JorandRunningenNTNU/ByggernLab/Hardware versjonskontroll/Lab 2.jpg

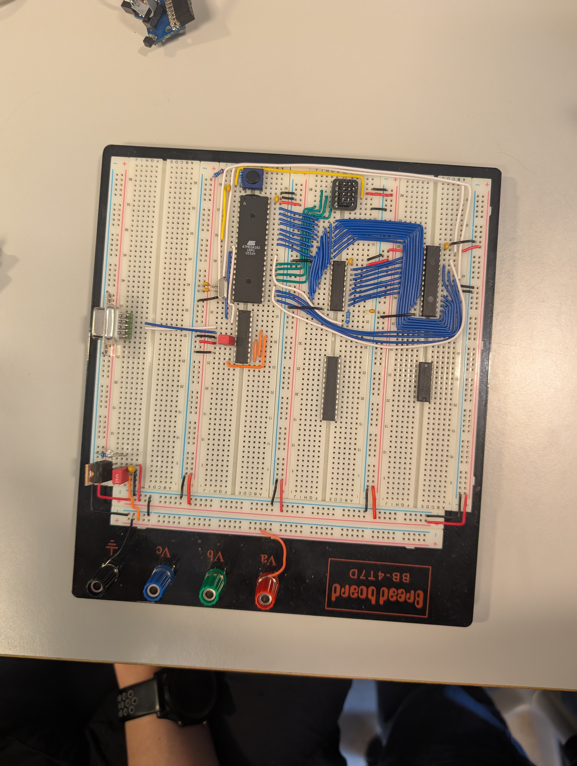
Hardware versjonskontroll/Lab 2.jpg
