JorandRunningenNTNU/ByggernLab/Hardware versjonskontroll/Lab 3.jpg

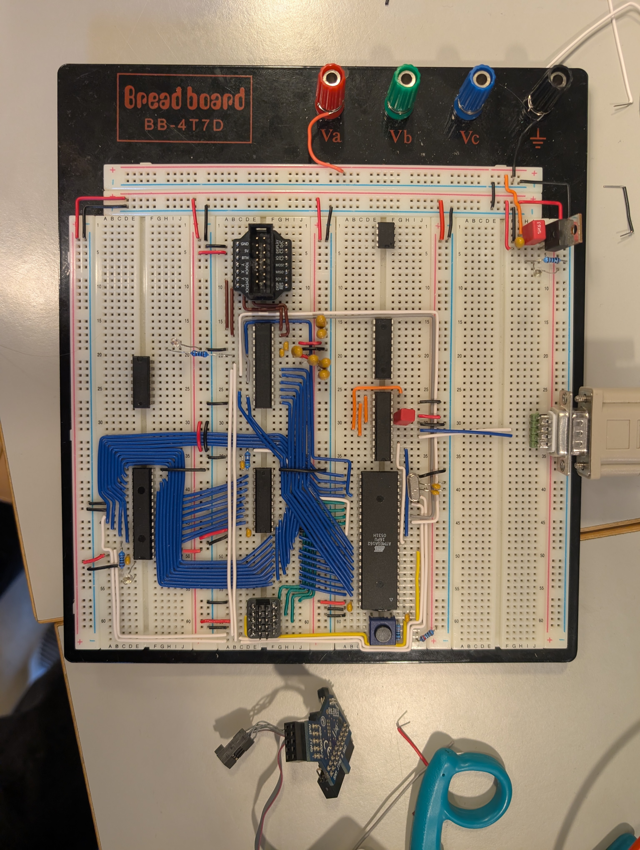
Hardware versjonskontroll/Lab 3.jpg
