JorandRunningenNTNU/ByggernLab/Byggern_Schematics.pdf

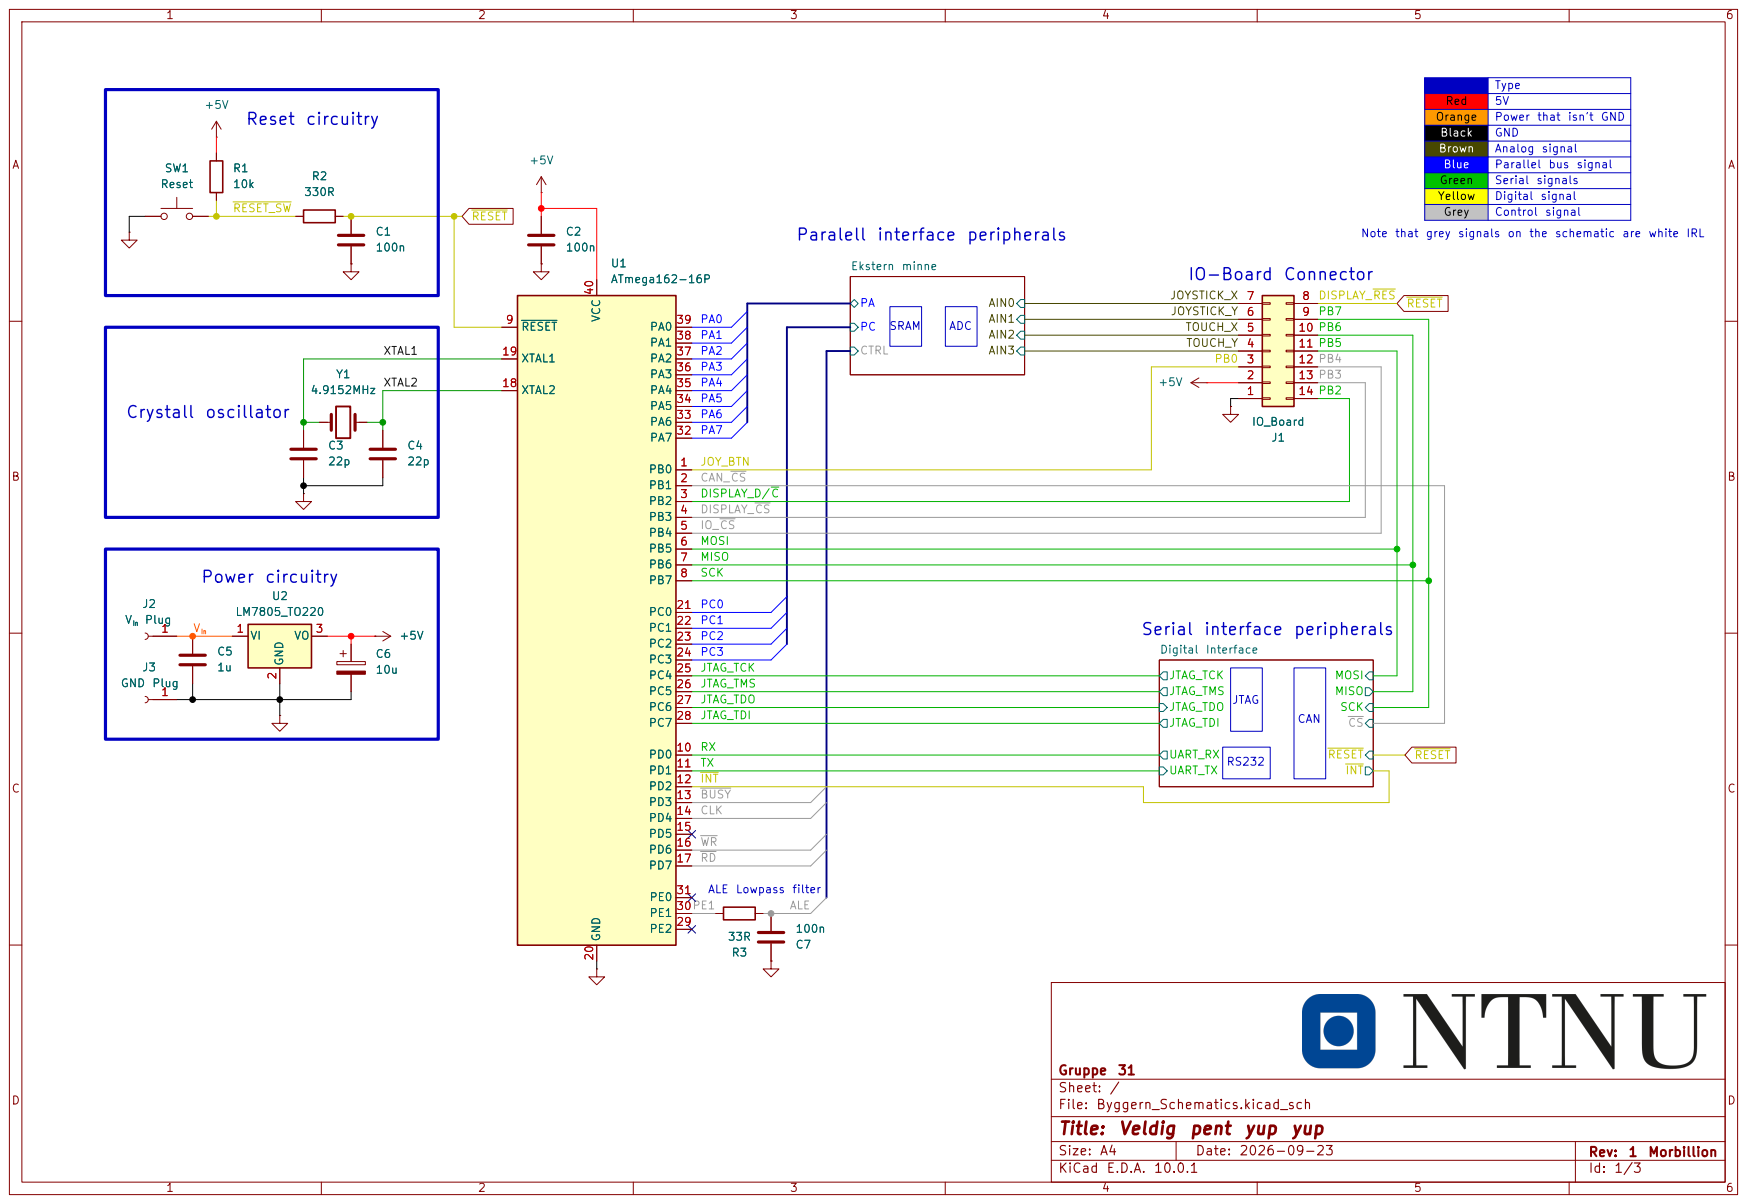
[picture p21: page 1]

Note that grey signals on the schematic are white IRL

TOUCH_X PB0 4 4 | 11 11

Y1 Y1 XTAL2 | XTAL2 18

JTAG_TDI JTAG_TCK JTAG_TMS

JTAG_TDO

RX
TX

Gruppe 31
Sheet: /
File: Byggern_Schematics.kicad_sch
Title: Veldig pent yup yup

Size: A4 | Rev: 1 Morbillion
KiCad E.D.A. 10.0.1 | Id: 1/3

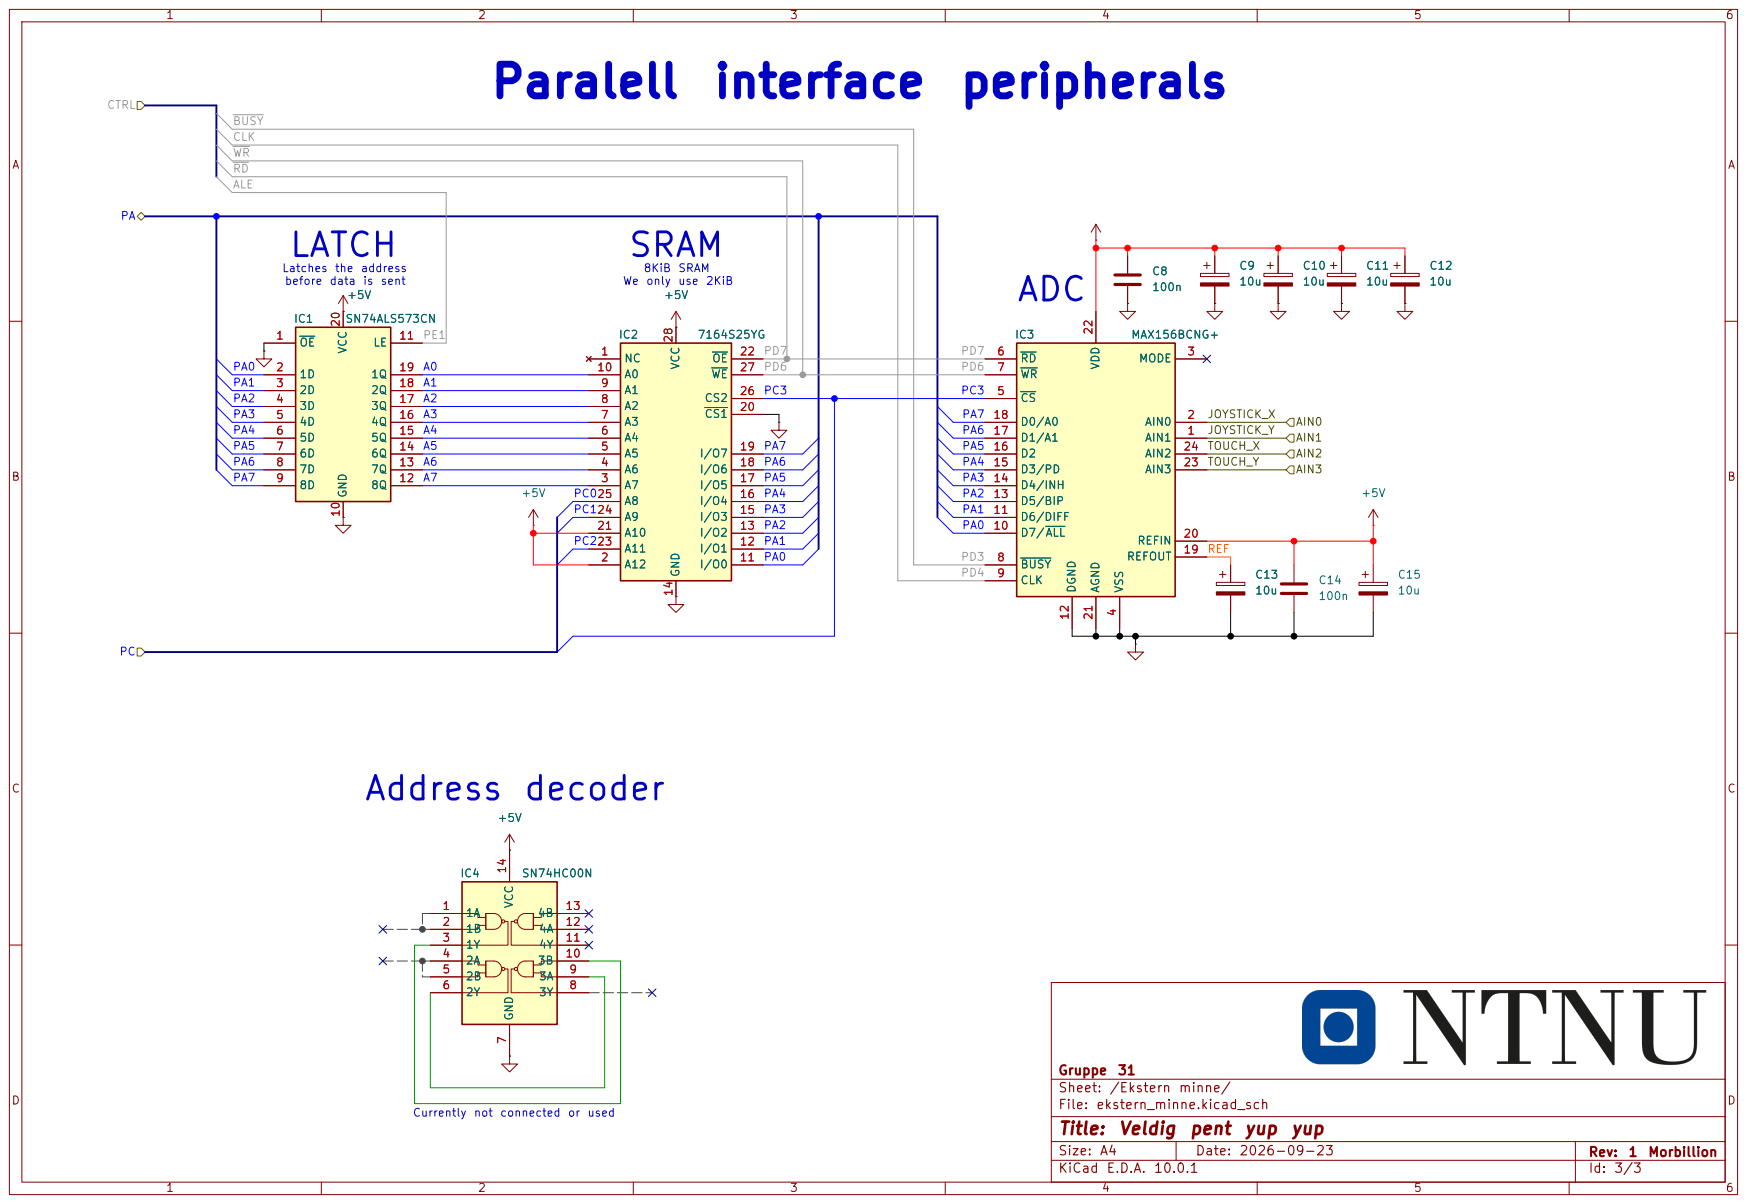
[picture p22: page 2]

4 CS 5 RD 6 WR 7 BUSY 8 CLK 9 D7/ALL 10 D6/DIFF 11 DGND 12

Gruppe 31
Sheet: /Ekstern minne/
File: ekstern_minne.kicad_sch
Title: Veldig pent yup yup

Currently not connected or used

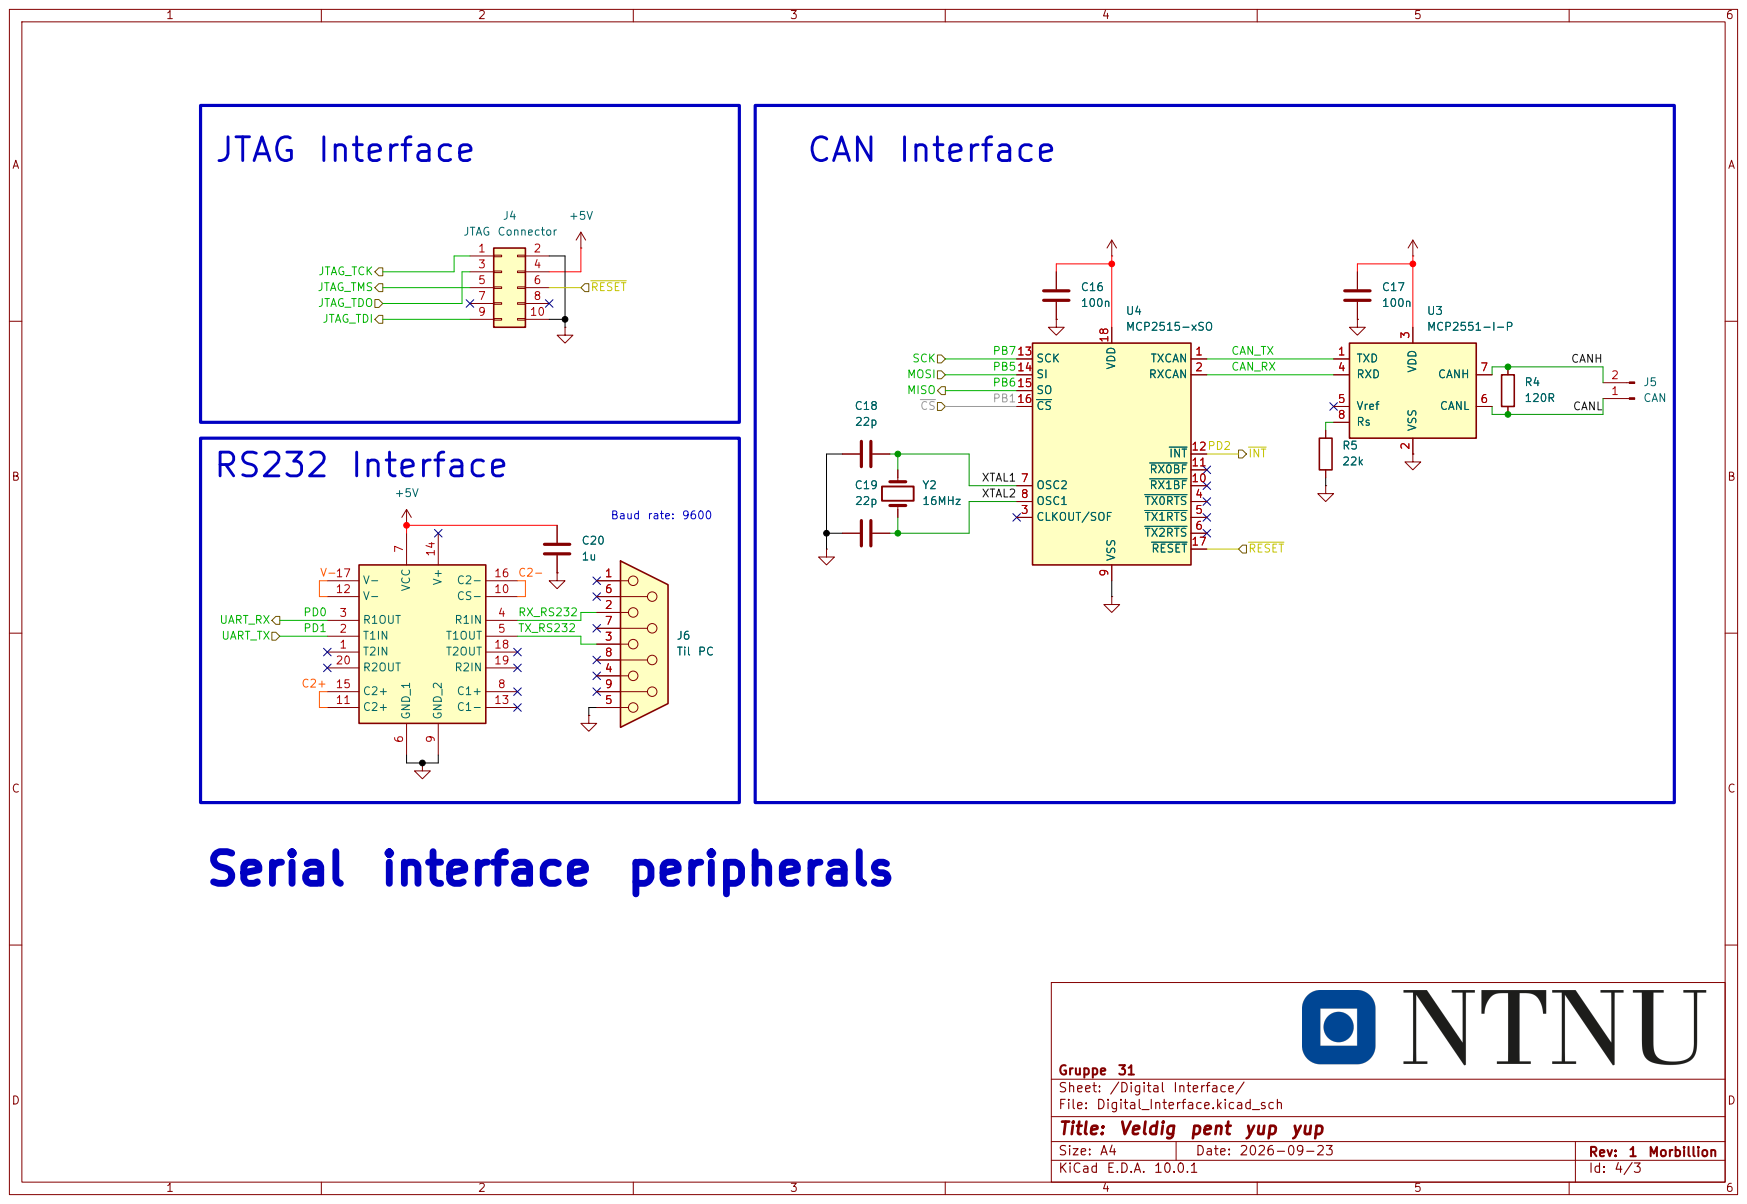
[picture p23: page 3]

INT RESET SCK MISO

Gruppe 31
Sheet: /Digital Interface/
File: Digital_Interface.kicad_sch
Title: Veldig pent yup yup
