JorandRunningenNTNU/ByggernLab/Byggern_Schematics/Byggern_Schematics.pdf

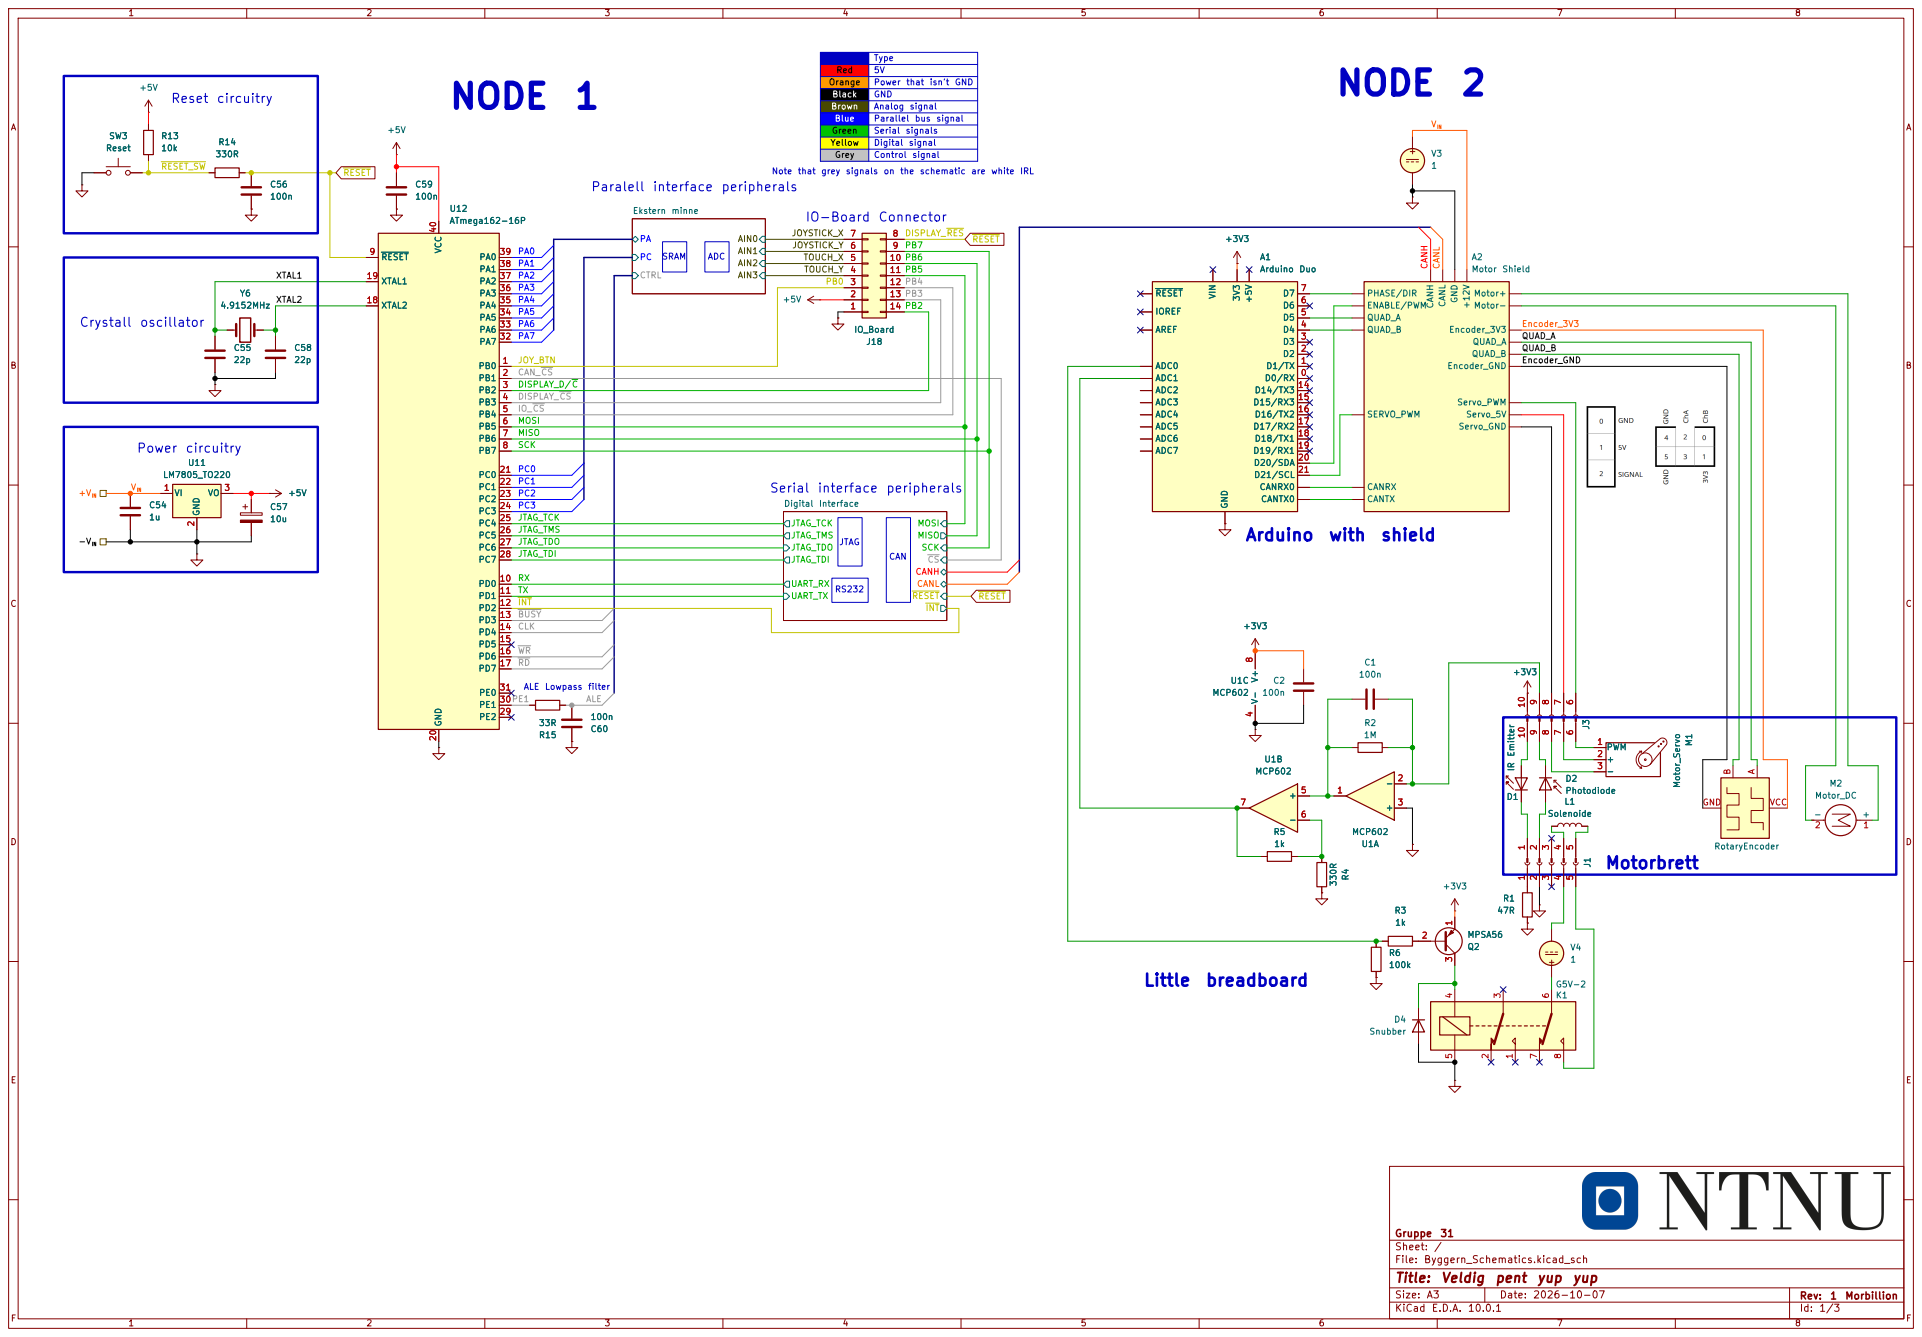
[picture p24: page 1]

Note that grey signals on the schematic are white IRL NODE 1

3 Q2MPSA56 +3V3 -V IN +V IN RESET RESET RESET CANL

JOYSTICK_Y 6 6 | 9 9
TOUCH_X 5 5 | 10 10

4 4 | 11 11
3 3 | 12 12

IO_Board +5V C57

JTAG_TMS PA6
DISPLAY_D/C WR | Serial interface peripherals
PC1 DISPLAY_CS MISO

SCK

Gruppe 31
Sheet: /
File: Byggern_Schematics.kicad_sch
Title: Veldig pent yup yup

Size: A3 | Rev: 1 Morbillion | F Date: 2026-10-07
KiCad E.D.A. 10.0.1 | Id: 1/3

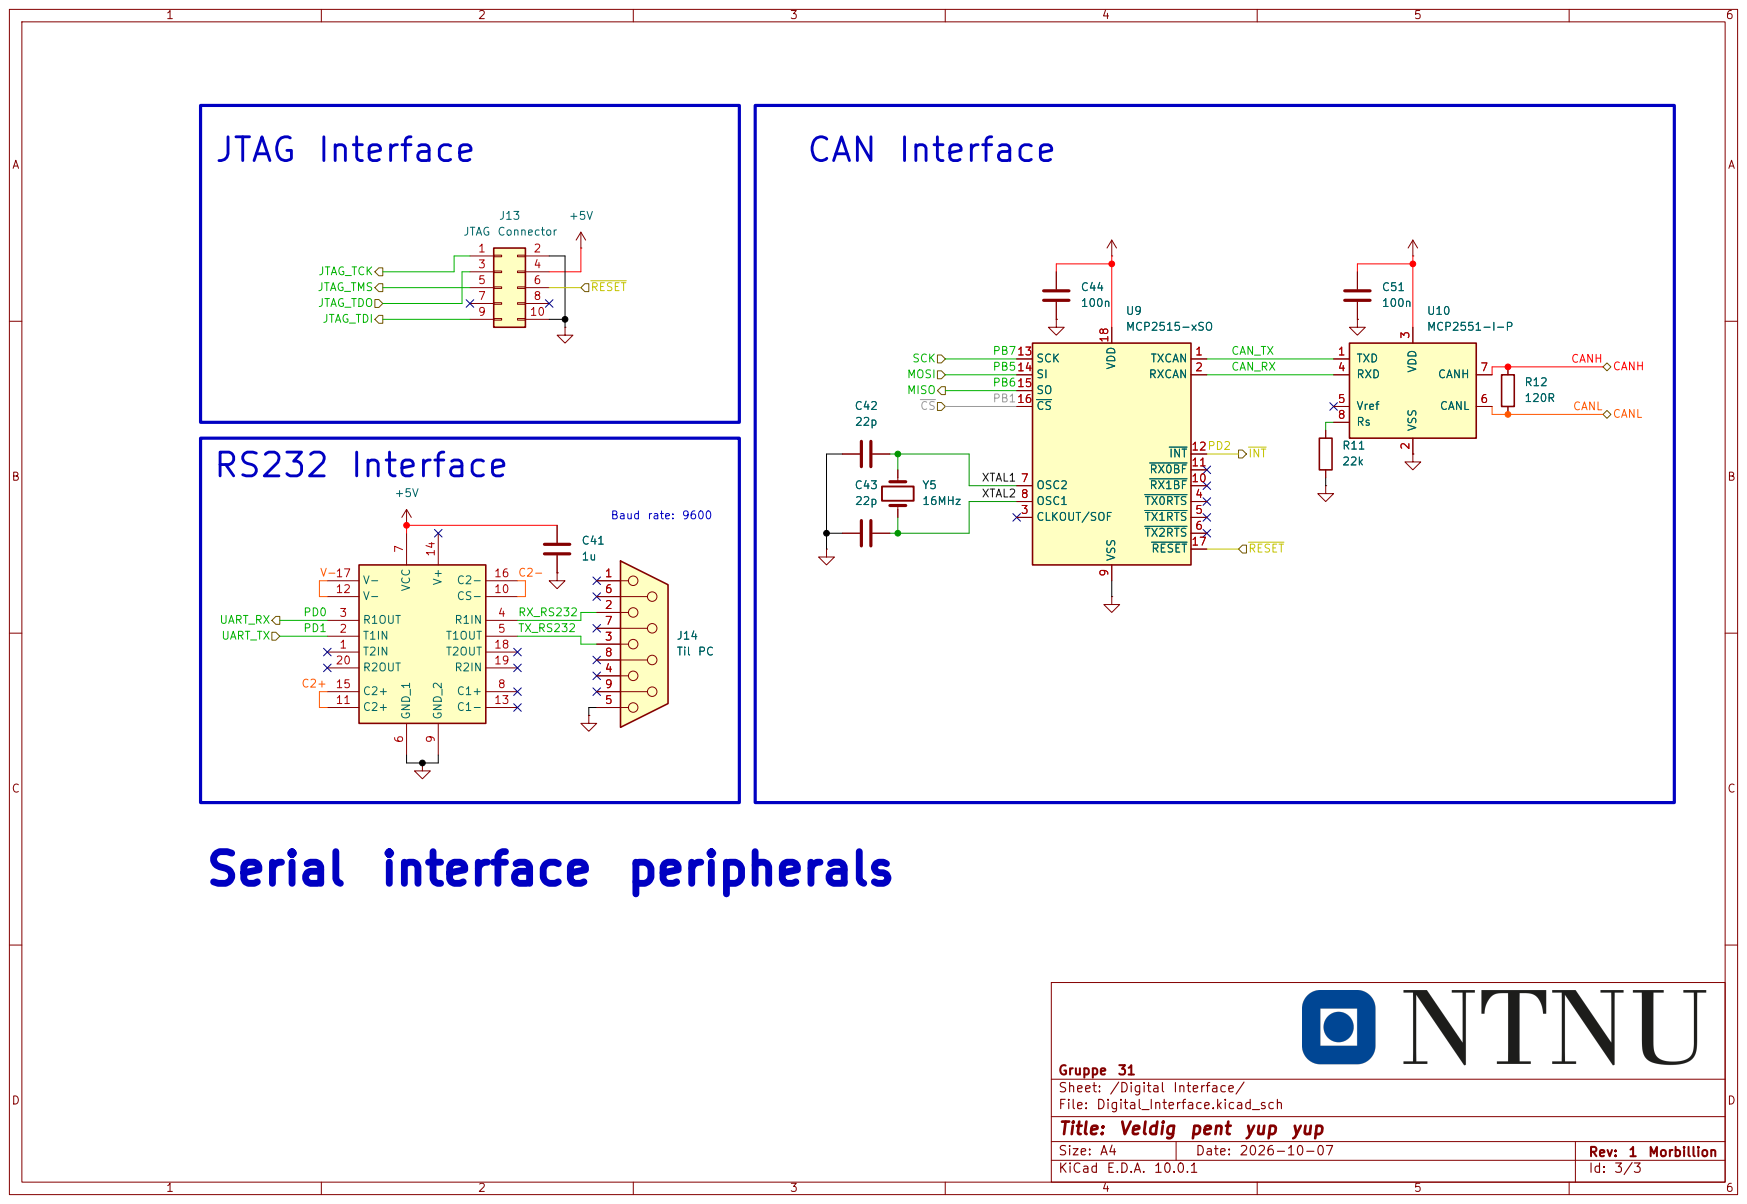
[picture p25: page 2]

Gruppe 31
Sheet: /Digital Interface/
File: Digital_Interface.kicad_sch
Title: Veldig pent yup yup

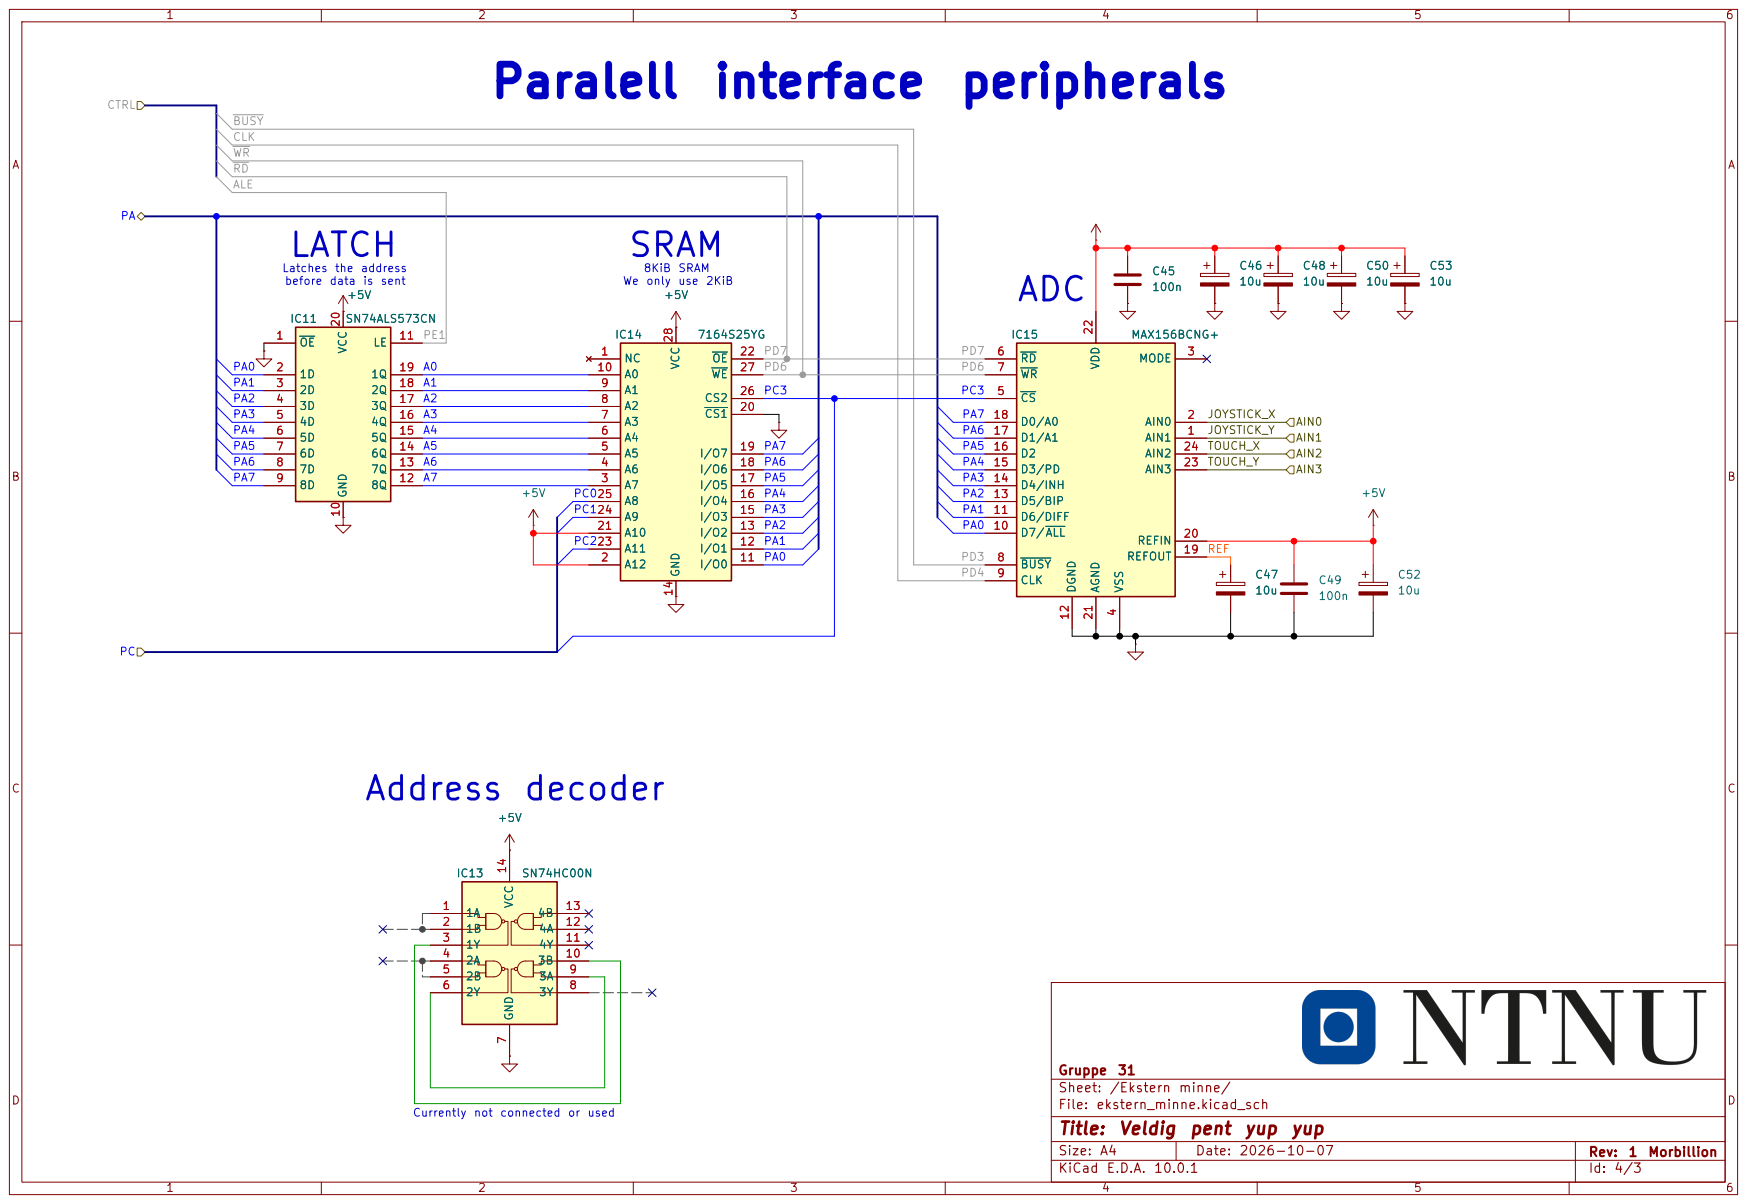
[picture p26: page 3]

4 CS 5 RD 6 WR 7 BUSY 8 CLK 9 D7/ALL 10 D6/DIFF 11 DGND 12

Gruppe 31
Sheet: /Ekstern minne/
File: ekstern_minne.kicad_sch
Title: Veldig pent yup yup

Currently not connected or used
