JorandRunningenNTNU/ByggernLab/Byggern_Schematics/Digital_Interface.kicad_sch

## KiCad design Byggern_Schematics/Digital_Interface.kicad_sch (2026-10-22)

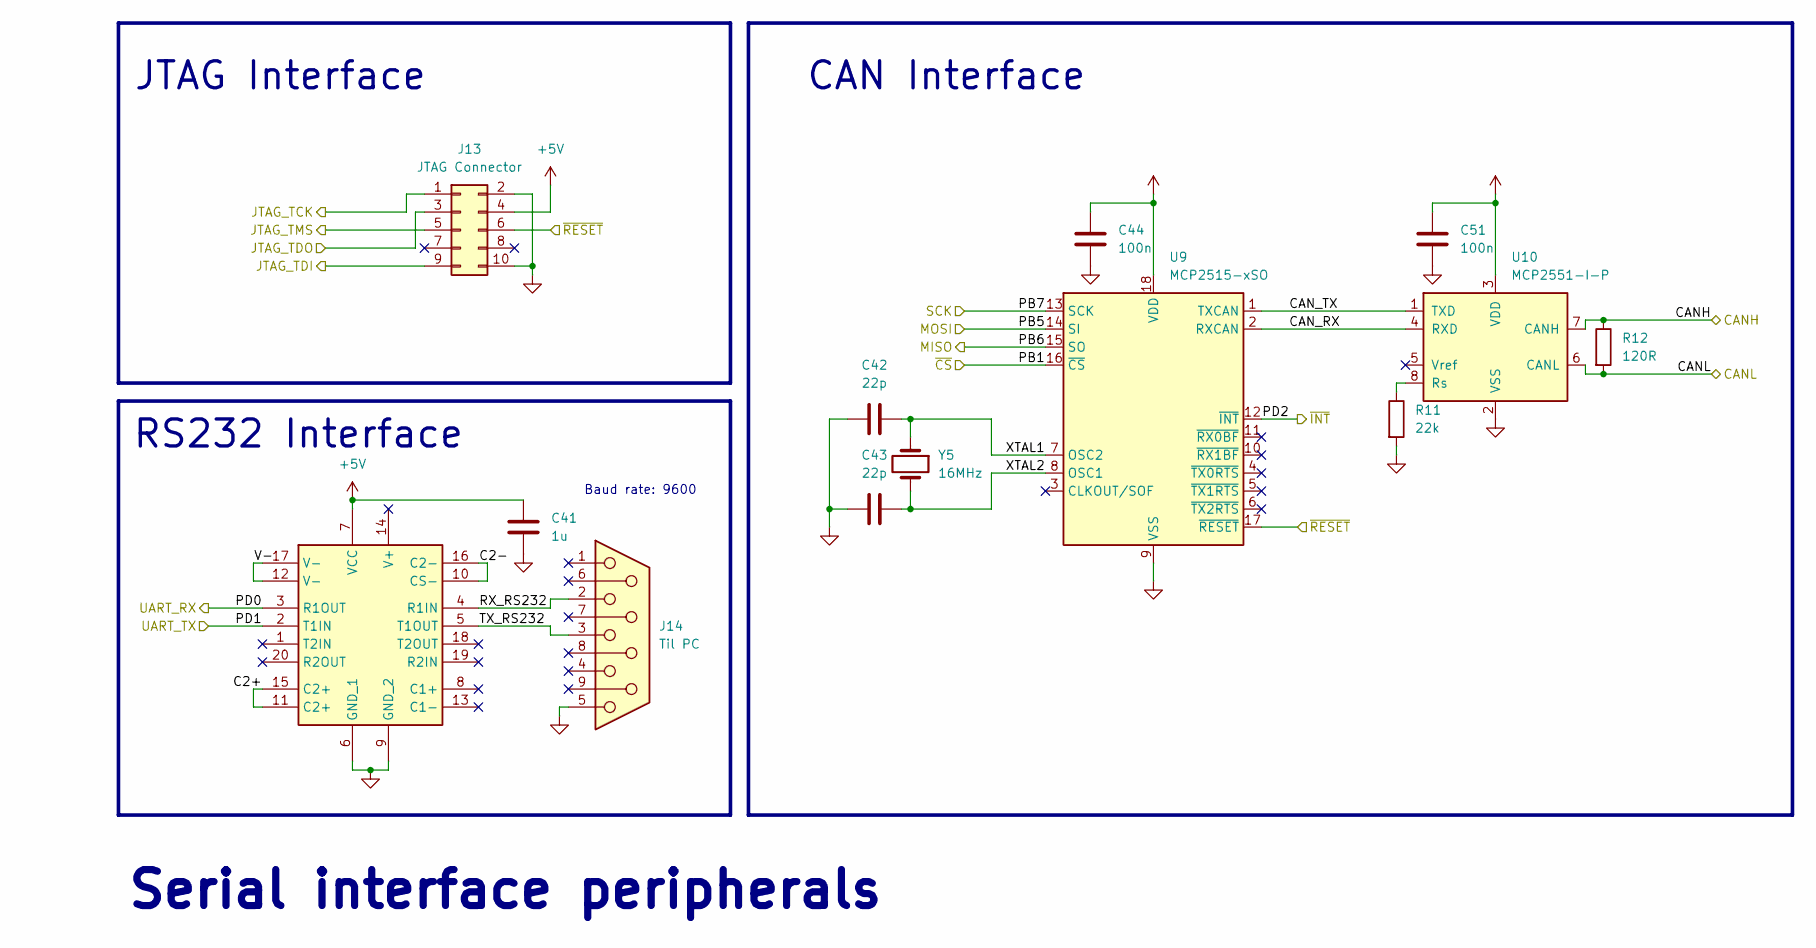
[picture p27: schematic Digital_Interface.kicad_sch]

Parts:
C41: 1u
C42, C43: 22p
C44, C51: 100n
IC12: MAX233; DIP762W56P254L2616H457Q20N; Mouser Part Number 700-MAX233CPPG36
J13: JTAG Connector
J14: Til PC
R11: 22k
R12: 120R
U9: MCP2515-xSO; TSSOP-20_4.4x6.5mm_P0.65mm
U10: MCP2551-I-P; DIP-8_W7.62mm
Y5: 16MHz

Connections:
+5V: C41.2, C44.1, C51.1, IC12.7 (VCC), J13.4, U9.18 (VDD), U10.3 (VDD)
C2+: IC12.11 (C2+), IC12.15 (C2+)
C2-: IC12.10 (CS-), IC12.16 (C2-)
CANH: R12.1, U10.7 (CANH)
CANL: R12.2, U10.6 (CANL)
CAN_RX: U9.2 (RXCAN), U10.4 (RXD)
CAN_TX: U9.1 (TXCAN), U10.1 (TXD)
GND: C41.1, C42.2, C43.1, C44.2, C51.2, IC12.6 (GND_1), IC12.9 (GND_2), J13.2, J13.10, J14.5, R11.2, U9.9 (VSS), U10.2 (VSS)
JTAG_TCK: J13.1
JTAG_TDI: J13.9
JTAG_TDO: J13.3
JTAG_TMS: J13.5
MISO: U9.15 (SO)
MOSI: U9.14 (SI)
unnamed: R11.1, U10.8 (Rs)
PB1: U9.16 (~CS)
PB7: U9.13 (SCK)
PD0: IC12.3 (R1OUT)
PD1: IC12.2 (T1IN)
PD2: U9.12 (~INT)
RX_RS232: IC12.4 (R1IN), J14.2
TX_RS232: IC12.5 (T1OUT), J14.3
V-: IC12.12 (V-), IC12.17 (V-)
XTAL1: C42.1, U9.7 (OSC2), Y5.1
XTAL2: C43.2, U9.8 (OSC1), Y5.2
~RESET: J13.6, U9.17 (~RESET)

Notes on the sheet:
RS232 Interface
JTAG Interface
Serial interface peripherals
CAN Interface
Baud rate: 9600
