JorandRunningenNTNU/ByggernLab/Byggern_Schematics/Node1.kicad_sch

## KiCad design Byggern_Schematics/Node1.kicad_sch (2026-10-28)

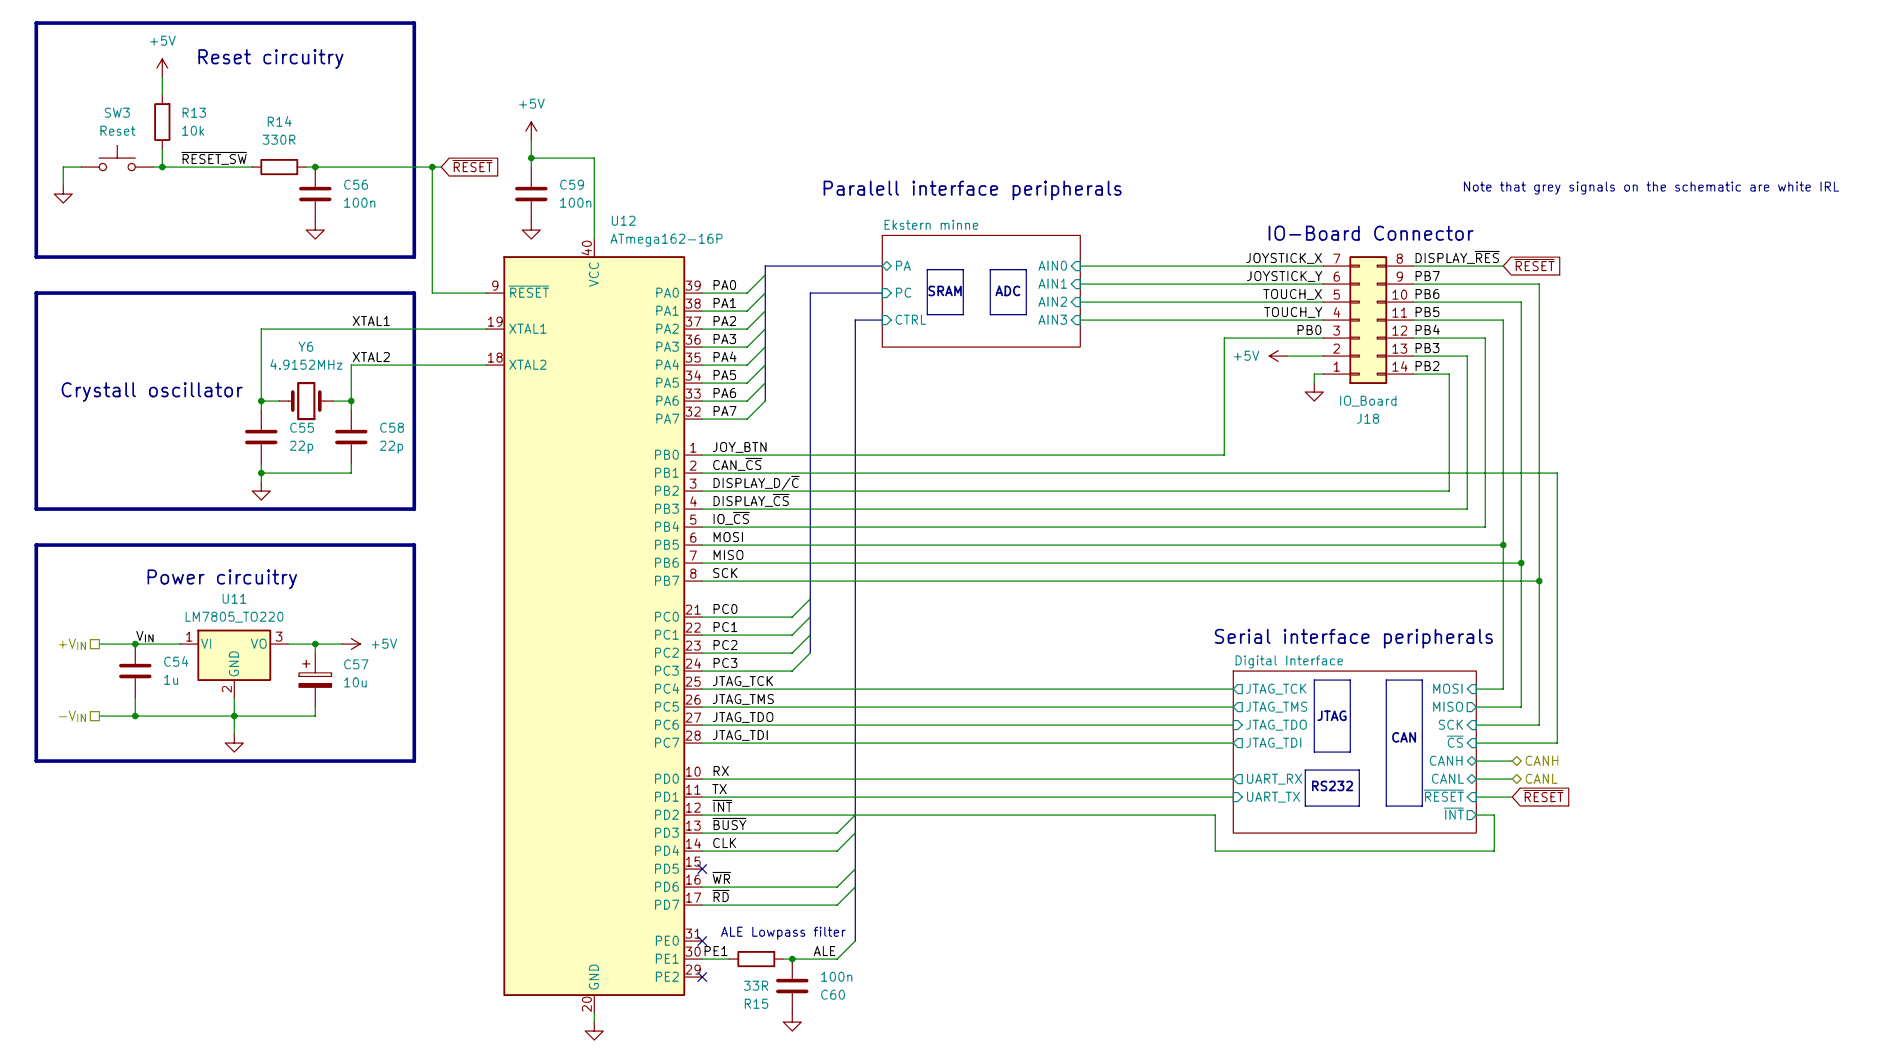
[picture p28: schematic Node1.kicad_sch]

Parts:
C54: 1u
C55, C58: 22p
C56, C59, C60: 100n
C57: 10u
J18: IO_Board; IDC-Header_2x07_P2.54mm_Vertical
R13: 10k
R14: 330R
R15: 33R
SW3: Reset
U11: LM7805_TO220; TO-220-3_Vertical
U12: ATmega162-16P; DIP-40_W15.24mm
Y6: 4.9152MHz

Connections:
+5V: C57.1, C59.1, J18.2, R13.2, U11.3 (VO), U12.40 (VCC)
+V_{IN}: C54.2, U11.1 (VI)
ALE: C60.1, R15.2
CAN_~CS: U12.2 (PB1)
CLK: U12.14 (PD4)
DISPLAY_D/~C: J18.14, U12.3 (PB2)
DISPLAY_~CS: J18.13, U12.4 (PB3)
GND: C54.1, C55.1, C56.2, C57.2, C58.1, C59.2, C60.2, J18.1, SW3.1, U11.2 (GND), U12.20 (GND)
IO_~CS: J18.12, U12.5 (PB4)
JOYSTICK_X: J18.7
JOYSTICK_Y: J18.6
JOY_BTN: J18.3, U12.1 (PB0)
JTAG_TCK: U12.25 (PC4)
JTAG_TDI: U12.28 (PC7)
JTAG_TDO: U12.27 (PC6)
JTAG_TMS: U12.26 (PC5)
MISO: J18.10, U12.7 (PB6)
MOSI: J18.11, U12.6 (PB5)
PA0: U12.39 (PA0)
PA1: U12.38 (PA1)
PA2: U12.37 (PA2)
PA3: U12.36 (PA3)
PA4: U12.35 (PA4)
PA5: U12.34 (PA5)
PA6: U12.33 (PA6)
PA7: U12.32 (PA7)
PB7: J18.9, U12.8 (PB7)
PC0: U12.21 (PC0)
PC1: U12.22 (PC1)
PC2: U12.23 (PC2)
PC3: U12.24 (PC3)
PE1: R15.1, U12.30 (PE1)
RX: U12.10 (PD0)
TOUCH_X: J18.5
TOUCH_Y: J18.4
TX: U12.11 (PD1)
XTAL1: C55.2, U12.19 (XTAL1), Y6.2
XTAL2: C58.2, U12.18 (XTAL2), Y6.1
~BUSY: U12.13 (PD3)
~INT: U12.12 (PD2)
~RD: U12.17 (PD7)
~RESET_SW: R13.1, R14.1, SW3.2
~RESET: C56.1, J18.8, R14.2, U12.9 (~RESET)
~WR: U12.16 (PD6)

Notes on the sheet:
JTAG
Serial interface peripherals
CAN
Paralell interface peripherals
Reset circuitry
Note that grey signals on the schematic are white IRL
RS232
ALE Lowpass filter
Crystall oscillator
IO-Board Connector
ADC
Power circuitry
SRAM
