JorandRunningenNTNU/ByggernLab/Byggern_Schematics/Node2.kicad_sch

## KiCad design Byggern_Schematics/Node2.kicad_sch (2026-10-28)

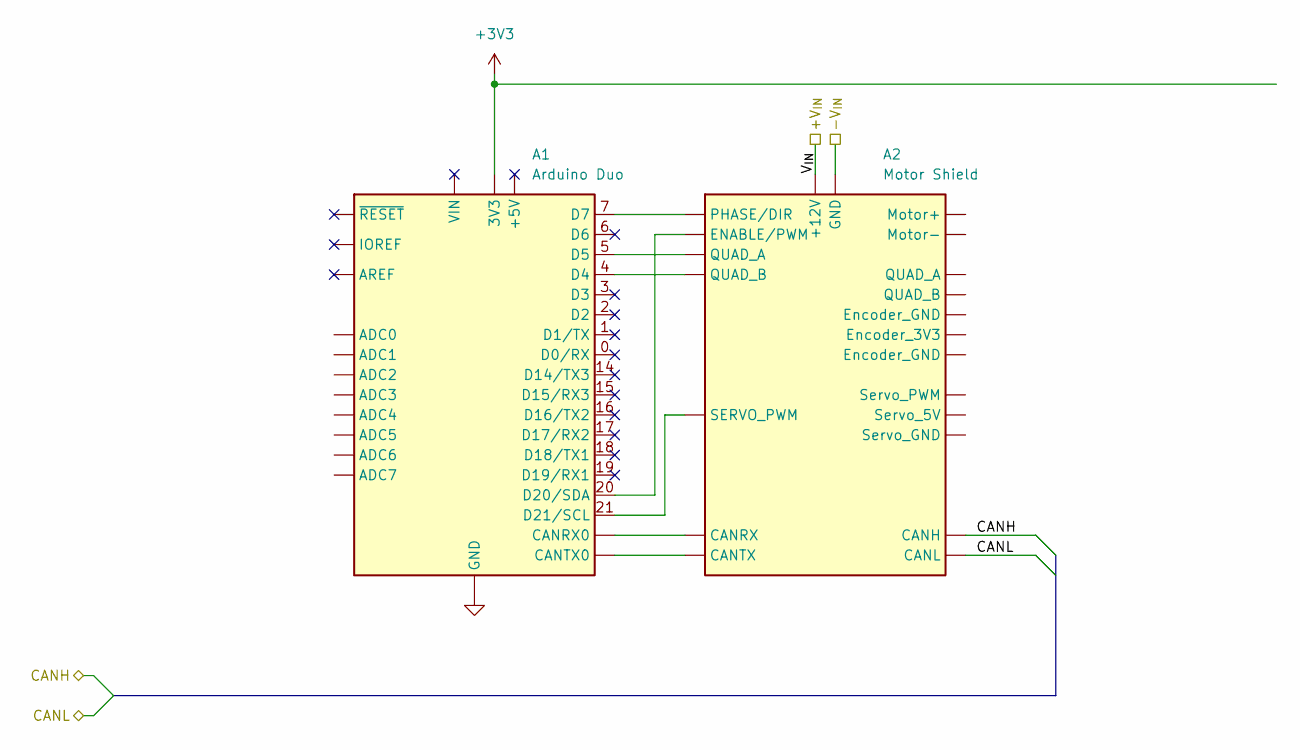
[picture p29: schematic Node2.kicad_sch]

Parts:
A1: Arduino Duo; Arduino_UNO_R3
A2: Motor Shield; Arduino_UNO_R3

Connections:
+3V3: A1. (~RESET)
+V_{IN}: A2.
-V_{IN}: A2.
CANH: A2.
CANL: A2.
GND: A1. (~RESET)
unnamed: A1.4 (D4), A2.
unnamed: A1.5 (D5), A2.
unnamed: A1.7 (D7), A2.
unnamed: A1.20 (D20/SDA), A2.
unnamed: A1.21 (D21/SCL), A2.
unnamed: A1. (~RESET), A2.
