JorandRunningenNTNU/ByggernLab/Byggern_Schematics/ekstern_minne.kicad_sch

## KiCad design Byggern_Schematics/ekstern_minne.kicad_sch (2026-10-28)

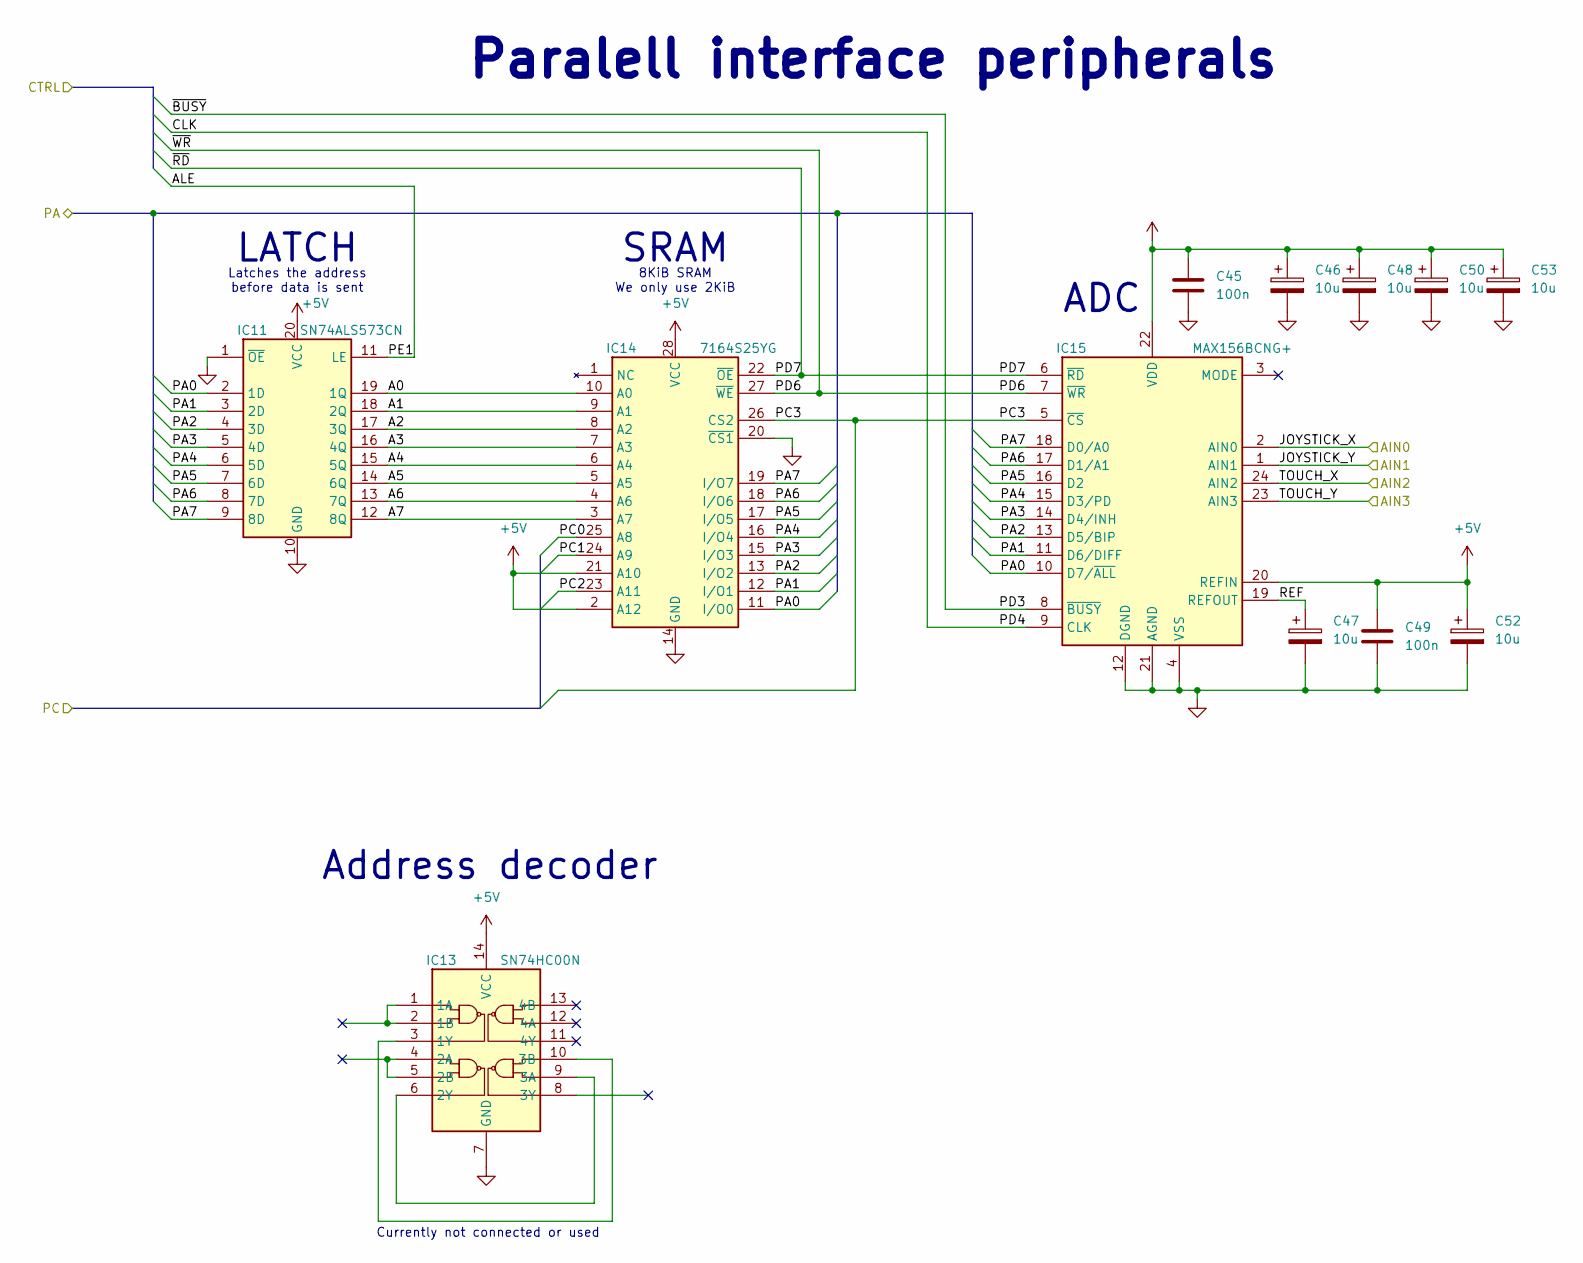
[picture p30: schematic ekstern_minne.kicad_sch]

Parts:
C45, C49: 100n
C46, C47, C48, C50, C52, C53: 10u
IC11: SN74ALS573CN; DIP794W53P254L2540H508Q20N; Mouser Part Number 595-SN74ALS573CN
IC13: SN74HC00N; DIP794W53P254L1930H508Q14N; Mouser Part Number 595-SN74HC00N
IC14: 7164S25YG; Mouser Part Number 972-7164S25YG
IC15: MAX156BCNG+; DIP794W56P254L3054H457Q24N; Mouser Part Number 700-MAX156BCNG

Connections:
+5V: C45.1, C46.1, C48.1, C49.1, C50.1, C52.1, C53.1, IC11.20 (VCC), IC13.14 (VCC), IC14.2 (A12), IC14.21 (A10), IC14.28 (VCC), IC15.20 (REFIN), IC15.22 (VDD)
A0: IC11.19 (1Q), IC14.10 (A0)
A1: IC11.18 (2Q), IC14.9 (A1)
A2: IC11.17 (3Q), IC14.8 (A2)
A3: IC11.16 (4Q), IC14.7 (A3)
A4: IC11.15 (5Q), IC14.6 (A4)
A5: IC11.14 (6Q), IC14.5 (A5)
A6: IC11.13 (7Q), IC14.4 (A6)
A7: IC11.12 (8Q), IC14.3 (A7)
AIN0: IC15.2 (AIN0)
AIN1: IC15.1 (AIN1)
AIN2: IC15.24 (AIN2)
AIN3: IC15.23 (AIN3)
ALE: IC11.11 (LE)
CLK: IC15.9 (CLK)
GND: C45.2, C46.2, C47.2, C48.2, C49.2, C50.2, C52.2, C53.2, IC11.1 (~OE), IC11.10 (GND), IC13.7 (GND), IC14.14 (GND), IC14.20 (~CS1), IC15.4 (VSS), IC15.12 (DGND), IC15.21 (AGND)
unnamed: IC13.1 (1A), IC13.2 (1B)
unnamed: IC13.4 (2A), IC13.5 (2B)
unnamed: IC13.6 (2Y), IC13.9 (3A)
unnamed: IC13.3 (1Y), IC13.10 (3B)
PA0: IC11.2 (1D), IC14.11 (I/O0), IC15.10 (D7/~ALL)
PA1: IC11.3 (2D), IC14.12 (I/O1), IC15.11 (D6/DIFF)
PA2: IC11.4 (3D), IC14.13 (I/O2), IC15.13 (D5/BIP)
PA3: IC11.5 (4D), IC14.15 (I/O3), IC15.14 (D4/INH)
PA4: IC11.6 (5D), IC14.16 (I/O4), IC15.15 (D3/PD)
PA5: IC11.7 (6D), IC14.17 (I/O5), IC15.16 (D2)
PA6: IC11.8 (7D), IC14.18 (I/O6), IC15.17 (D1/A1)
PA7: IC11.9 (8D), IC14.19 (I/O7), IC15.18 (D0/A0)
PC0: IC14.25 (A8)
PC1: IC14.24 (A9)
PC2: IC14.23 (A11)
PC3: IC14.26 (CS2), IC15.5 (~CS)
PD3: IC15.8 (~BUSY)
PD6: IC14.27 (~WE), IC15.7 (~WR)
PD7: IC14.22 (~OE), IC15.6 (~RD)
REF: C47.1, IC15.19 (REFOUT)

Notes on the sheet:
Address decoder
Currently not connected or used
SRAM
Paralell interface peripherals
Latches the address before data is sent
ADC
LATCH
8KiB SRAM We only use 2KiB
