JorandRunningenNTNU/ByggernLab/Byggern_Schematics/ping_pong_board.kicad_sch

## KiCad design Byggern_Schematics/ping_pong_board.kicad_sch (2026-10-22)

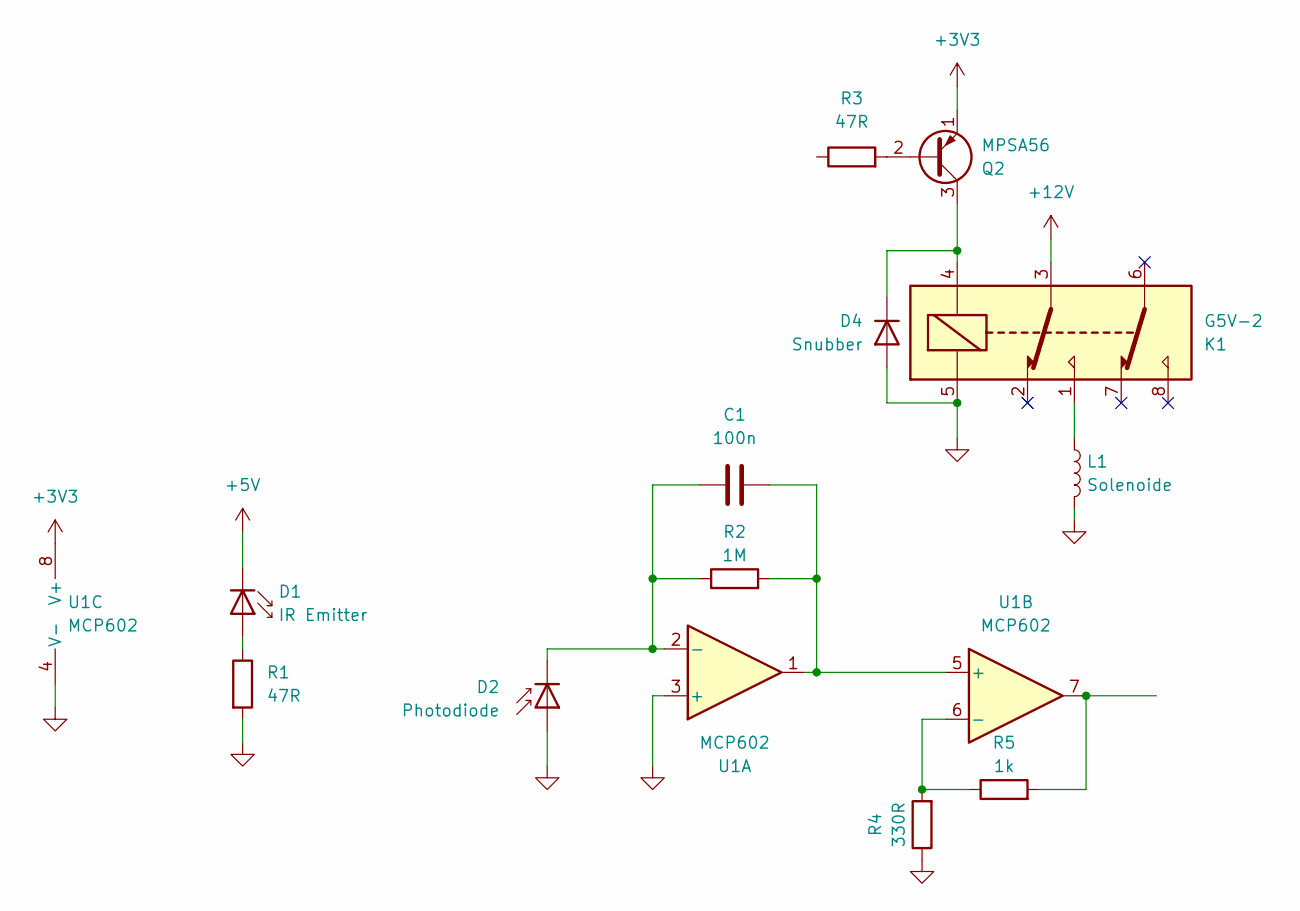
[picture p31: schematic ping_pong_board.kicad_sch]

Parts:
C1: 100n
D1: IR Emitter; LED_D3.0mm_IRBlack
D2: Photodiode
D4: Snubber; D_DO-41_SOD81_P10.16mm_Horizontal
K1: G5V-2; Relay_DPDT_Omron_G5V-2
L1: Solenoide
Q2: MPSA56; TO-92_Inline
R1, R3: 47R
R2: 1M
R4: 330R
R5: 1k
U1: MCP602

Connections:
+3V3: Q2.1 (E), U1.8 (V+)
+5V: D1.1 (K)
+12V: K1.3
GND: D2.2 (A), D4.2 (A), K1.5, L1.2, R1.2, R4.1, U1.3 (+), U1.4 (V-)
unnamed: C1.1, D2.1 (K), R2.1, U1.2 (-)
unnamed: C1.2, R2.2, U1.1, U1.5 (+)
unnamed: D1.2 (A), R1.1
unnamed: D4.1 (K), K1.4, Q2.3 (C)
unnamed: K1.1, L1.1
unnamed: Q2.2 (B), R3.2
unnamed: R4.2, R5.1, U1.6 (-)
unnamed: R5.2, U1.7
