JorandRunningenNTNU/ByggernLab/MamdanisNewYork/MamdanisNewYork/main.c

#include "sam.h"
#include "uart.h"
#include <stdio.h>
#include "include/test.h"
#include "servo.h"
#include "pwm.h"
#include "can.h"
#include "encoder.h"
#include "adc.h"
#include "motor_controller.h"
#include "solenoide.h"
#include "da_beep.h"
#include "heart_sounds.h"
#include "our_timer.h"

// 100% menneskeskrevet

extern bool play_da_heart_sound;

int main(void){
    SystemInit(); // for mikrokontrolleren
	WDT->WDT_MR = WDT_MR_WDDIS; // <3 <3 <3 watchdawg timer DISABEL!
	
	uart_init(F_CPU, 9600);
	pwm_init();
	encoder_init();
	servo_init();
	solenoide_init();
	motor_controller_init(1000);
	can_setup();
	adc_setup();
	
	printf("Klar for de game \r\n");
	while(1){
		if(play_da_heart_sound){
			timer_channel_deinit(2);
			timer_channel_init(10,motor_controller_jiggle,2);
			uint16_t count = 50000;
			while(count--);
			timer_channel_deinit(1);
			da_heart_loss_sequence();
			timer_channel_deinit(2);
			play_da_heart_sound = false;
		}
	}
}
