JorandRunningenNTNU/ByggernLab/BigBeautifulBroject/BigBeautifulBroject/source/sram.c

#include <stdio.h>
#include "../include/sram.h"
#include "../include/drivere/uart.h"

void setupSRAM(){
	SFIOR |= (4 << 3); // ikke bruke JTAG-pins for adresse
	EMCUCR |= (0 << 1); // gir SRAM 2 sykler på å lese adresse før atmega skriver/leser
	MCUCR |= (0 << 6); // gir SRAM 2 sykler på å lese adresse før atmega skriver/leser
	MCUCR |= (1 <<7); // aktivere eksternt minne
	
	extern uint8_t __noinit_end;   // provided by the AVR linker script
	// e.g. in main():
	if ((uint16_t)&__noinit_end > 0x2000) {
		printf("Du bruker for mye minne din tulling\n");
		while(1);
	}
}

void sram_test(void)
{
	setupPrintfUART();
	
	volatile char *ext_ram = (char *) 0x1800;  // Start address for the SRAM
	uint16_t ext_ram_size = 0x800;
	uint16_t write_errors = 0;
	uint16_t retrieval_errors = 0;

	printf("Starting SRAM test... \n");

	// rand() stores some internal state, so calling this function in a loop
	// will yield different seeds each time (unless srand() is called before this
	// function)
	uint16_t seed = rand();

	// Write phase: Immediately check that the correct value was stored
	srand(seed);
	for (uint16_t i = 0; i < ext_ram_size; i++) {
		uint8_t some_value = rand();
		ext_ram[i] = some_value;

		uint8_t retrieved_value = ext_ram[i];
		if (retrieved_value != some_value) {
			printf("Write phase error: ext_ram[%4d] = %02X (should be %02X)\n",
			i, retrieved_value, some_value);
			write_errors++;
		}
	}

	// Retrieval phase: Check that no values were changed during or after the
	// write phase
	srand(seed);

	// reset the PRNG to the state it had before the write phase
	for (uint16_t i = 0; i < ext_ram_size; i++) {
		uint8_t some_value = rand();
		uint8_t retrieved_value = ext_ram[i];

		if (retrieved_value != some_value) {
			printf("Retrieval phase error: ext_ram[%4d] = %02X (should be %02X)\n",
			i, retrieved_value, some_value);
			retrieval_errors++;
		}
	}

	printf("SRAM test completed with \n%4d errors in write phase and \n%4d errors in retrieval phase\n\n",
	write_errors, retrieval_errors);
}
