JorandRunningenNTNU/ByggernLab/(commit log)

2026-09-03 La til skjematikk relaterte filer
    Kicad greier as, litt mange filer men har vel ikke så mye å si?
    [Byggern_Schematics.kicad_pcb, Byggern_Schematics.kicad_sch]
2026-09-05 schematics ting
    [ATmega162.kicad_sch, Byggern_Schematics.kicad_sch, Digital_Interface.kicad_sch, ekstern_minne.kicad_sch]
2026-09-16 Byggern sjematikk for ADC done
    [ATmega162.kicad_sch, Byggern_Schematics.kicad_sch, Digital_Interface.kicad_sch, ekstern_minne.kicad_sch]
2026-09-16 Schematic udated
    [Byggern_Schematics.kicad_sch, Digital_Interface.kicad_sch, ekstern_minne.kicad_sch]
2026-09-23 spi.h ferdig
2026-09-23 endre spi.h litt, og gjorde litt med sleep
2026-09-23 spi ferdig?
2026-09-23 Finnished schematic
    [Byggern_Schematics.kicad_pcb, Byggern_Schematics.kicad_sch, Digital_Interface.kicad_sch, ekstern_minne.kicad_sch]
2026-09-23 spi ser ut til å fungre
2026-09-30 la til ting i gitignore
2026-09-30 fixa gitignore og la til libraries i main
    [main.c]
2026-09-30 fixa spi driver
2026-09-30 fixa adc
2026-09-30 fixa uart
2026-09-30 implementerte interrupt basert uart
2026-10-02 Fixed a few menu bugs (Maily with empty root), added a menu_insert function, and added the menu to main, so test scripts can be added to the menu
    [main.c, menu.c, menu.h]
2026-10-05 Liten Schematic endring
    [Byggern_Schematics.kicad_sch, Digital_Interface.kicad_sch, ekstern_minne.kicad_sch]
2026-10-07 Enabla interrupts i uart
2026-10-07 Schematic endring
    [Byggern_Schematics.kicad_sch, Digital_Interface.kicad_sch]
2026-10-07 feat: lagde SPI interrupt send definisjon og deklarasjon
2026-10-07 mcp2515 driver, lab 5 ferdig
2026-10-07 fixa navn på ting
    [joystick.c, menu.c, oled.c, spi.c, sram.c, uart.c]
2026-10-07 uart little fix
2026-10-14 Node 2 uart virker
2026-10-14 små schematic ting
2026-10-21 Added timer and length limit to file names
2026-10-21 servo driver done
2026-10-21 added encoder driver thingymajig
2026-10-21 mamdanis adc fungerer
2026-10-22 Små endringer til schematic
2026-10-27 A lot of schematic changes
2026-10-28 Små schematic endringer
2026-10-28 Små schematic endringer og eksporterte som PDF
2026-10-28 Pwm done i think not tested
    Ikke koble til servo
2026-11-04 Fixa pwm driver. fixa servo driver
2026-11-04 timer for node 1
2026-11-04 Solenoide-driver, opps språkbruk! Mente magnet-greie-driver
2026-11-04 timer thingymajigs
2026-11-04 motorkontroller er itte så hakkaens gærn at vi itte kan bruke han
2026-11-04 finished interrupt, tried to reduce mem usage of degame. Menu still corrupts after launching degame. Presumably because of memory overlap.
2026-11-04 La til can interface og refactora timeren
2026-11-04 Refactored timer to use interrupts
2026-11-04 Timer builds you know
2026-11-10 drepte en bug i timer_done()
2026-11-10 lagde en oppstartssekvens for motor kontroller
2026-11-10 fiksa ADC
2026-11-11 La til flere timer funksjonaliteter
2026-11-11 Added change frequency feature to the pwm
